ic1414/esp_quad/README.md

# esp_quad

四轴飞行器
quadcopter

## 2022-08-13
esp_quad_v4.1

增加web调参

删除蓝牙调参

## 2022-06-17
esp_quad_v4.0

增加蓝牙调参

支持sbus接收机

支持dshot

删除遥控调参

## 123
支持遥控直接调PID! (正在加蓝牙调参)

不知道要写什么，到时候补充。
