ic1414/esp_quad/pcb/pcb_v2/README.md

## 注意
引脚和 pcb_v1 不兼容，需要去程序改下。

## 物料清单: 
### 无人机:
F450 机架

2212 1000kv 电机(我的电机最大15A)

9047 propeller

Blhelis 30A ESC or 4 in one ESC 

2200mAh 35C lipo (建议选>35C)

飞控

### 飞控
ESP32-WROOM-32U or ESP32-WROOM-32D

AMS1117 3V3  SOT223

MPU6050(GY521)

Buck converter (optional)

NRF24l01 smd or NRF24l01 gt24

0805 resistors 10kX3 & 12kX2 & 3k & 7k5 & 33k

typeA tantalum capacitor 22uf

0805 cerammic capacitor 10ufX2 & 0.1ufX2

jst sh1.0 horizontal smd 4pX2 & 6pX4

pcb 大小:39*39mm

## 图片
图片

图片

图片

图片

## 建议
你可能需要给你的桨叶动平衡。可以用一些胶带。
