ic1414/esp_quad/pcb/pcb_v2/pic.jpg

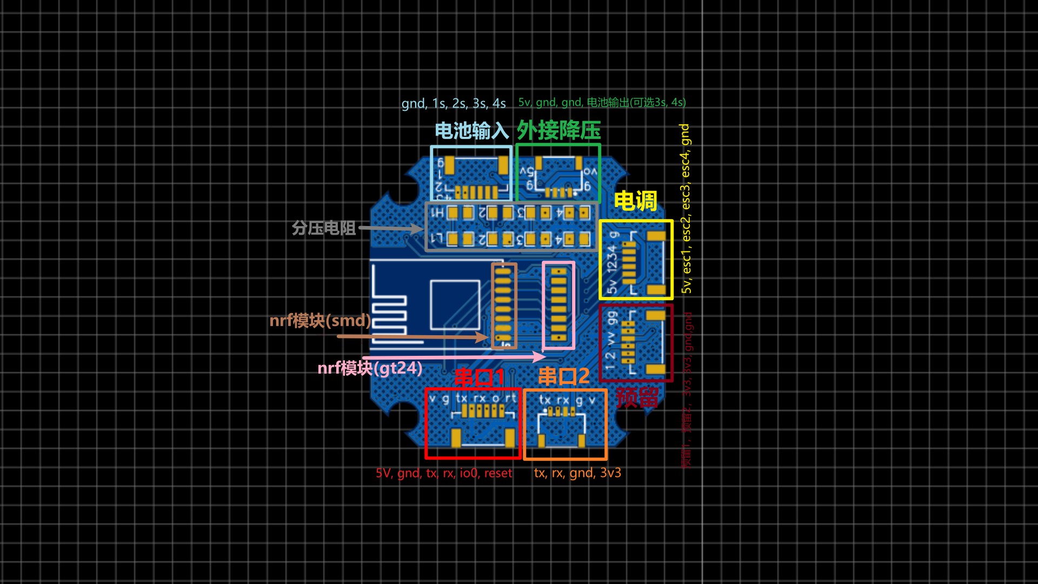
pcb/pcb_v2/pic.jpg
