ic1414/esp_quad/pcb/pcb_v2/schematic2.jpg

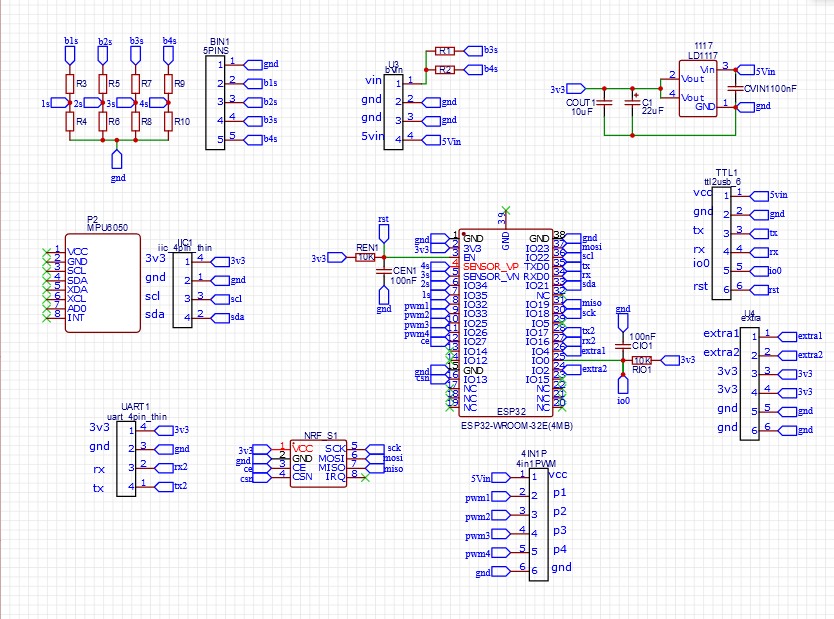
pcb/pcb_v2/schematic2.jpg
