ic1414/esp_quad/document/esp_quad_tutorial_v1/images/board pins.jpeg

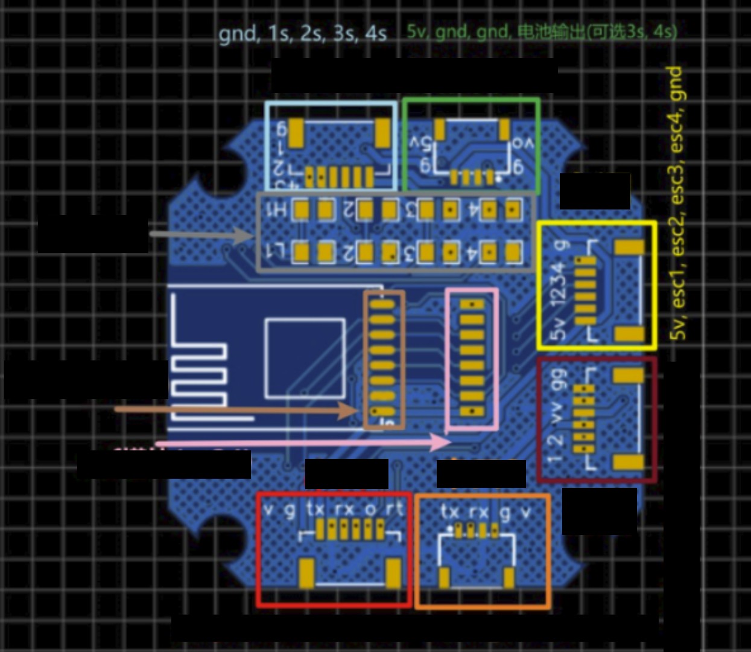
document/esp_quad_tutorial_v1/images/board pins.jpeg
