ic1414/esp_quad/(threads)

Thread 4 (2023-01-13):

Is there a simple\short installation tutorial?

NowLoadY, 2023-01-13:
I'm not very familiar with your project, but I think it interesting. Are there any related video or articles?
And thanks for working on your project, it's nice!

ic1414, 2023-01-14:
Sorry @NowLoadY, there is no short installation tutorial in English yet, but in Chinese. English version will be available soon(within one month).

ic1414, 2023-02-03:
@NowLoadY. you can find tutorial in English here https://github.com/ic1414/esp_quad/tree/main/document/esp_quad_tutorial_v1 .

NowLoadY, 2023-02-03:
> @NowLoadY. you can find tutorial in English here https://github.com/ic1414/esp_quad/tree/main/document/esp_quad_tutorial_v1 .

thanks！！！🙏

Closed 2023-04-06.
