ic1414/esp_quad/src/esp_quad_v4.1/include/inclu.h

#ifndef _inclu_h_
#define _inclu_h_

/*
<SimpleKalmanFilter.h>
-author
Denys Sene
https://github.com/denyssene/SimpleKalmanFilter

*/

#include <Arduino.h>
#include <SimpleKalmanFilter.h>
#include "config.h"
#include "pid.h"
#include "mpu.h"
#include "vtg.h"
#include "motor.h"
#include "wifiServerr.h"
#include "reciever.h"
#include "seriale.h"

#endif
