ic1414/esp_quad/src/esp_quad_v4.1/include/seriale.h

#ifndef _seriale_h_
#define _seriale_h_

#include "config.h"

int serial_zip(){
    
    int delay_time = 10; 
    static char str = '1';
    if (Serial.available() > 0) str = Serial.read();

    switch (str) {
      // print angle
      case 'a':
        Serial.print(imu.getAngle(X));
        Serial.print("   ");
        Serial.print(imu.getAngle(Y));
        Serial.print("   ");
        Serial.println(imu.getAngle(Z));
        break;
      // print gyro
      case 'b':
        Serial.print(imu.getGyro(X));
        Serial.print("   ");
        Serial.print(imu.getGyro(Y));
        Serial.print("   ");
        Serial.println(imu.getGyro(Z));
        break;
      // print acc
      case 'c':
        Serial.print(imu.getAcc(X));
        Serial.print("   ");
        Serial.print(imu.getAcc(Y));
        Serial.print("   ");
        Serial.println(imu.getAcc(Z));
        break;
      // sample count
      case 'd':
        Serial.println(imu.getSampleCount(true));
        delay_time = 1000;
        break;  
      // motor outputs
      case 'e':
        Serial.print("B:");
        Serial.print(motorB.getAStandardisedPwm());
        Serial.print("  A:");
        Serial.print(motorA.getAStandardisedPwm());
        Serial.print("  D:");
        Serial.print(motorD.getAStandardisedPwm());
        Serial.print("  C:");
        Serial.println(motorC.getAStandardisedPwm());
        break;    
      // hi
      case 'f':
        Serial.print("v1s: ");
        Serial.print(voltage.getVoltage(V1));
        Serial.print("  v2s: ");
        Serial.print(voltage.getVoltage(V2));
        Serial.print("  v3s: ");
        Serial.println(voltage.getVoltage(V3));
        break; 

      case 'g':
        Serial.print("x: ");
        Serial.print(imu.getAccAngle(X));
        Serial.print("  y: ");
        Serial.println(imu.getAccAngle(Y));
        break; 

      case 'h':
        // motor outputs
        Serial.print("x:");
        Serial.print(reciever.getJoyStick(X));
        Serial.print("  y:");
        Serial.print(reciever.getJoyStick(Y));
        Serial.print("  z:");
        Serial.print(reciever.getJoyStick(Z));
        Serial.print("  t:");
        Serial.println(reciever.getJoyStick(T));
        break;  

      case 'i':
        // motor outputs
        Serial.print("x:");
        Serial.print(map(reciever.getJoyStick(X), recie_minJoyAnalog, recie_maxJoyAnalog, -recie_maxJoyAngleX, recie_maxJoyAngleX));
        Serial.print("  y:");
        Serial.print(map(reciever.getJoyStick(Y), recie_minJoyAnalog, recie_maxJoyAnalog, -recie_maxJoyAngleY, recie_maxJoyAngleY));
        Serial.print("  z:");
        Serial.println(map(reciever.getJoyStick(Z), recie_minJoyAnalog, recie_maxJoyAnalog, -recie_maxJoyAngleZ, recie_maxJoyAngleZ));
        break;  

    }
    
    return delay_time;
}
#endif
