ic1414/esp_quad/(commit log)

2022-02-16 higher mpu6050 sample rate
    increase mpu6050 sample rate from 1600HZ to 2600HZ
2022-04-10 Add files via upload
    fix mpu6050 code
    [inclu.h, motor.h, mpu.h, pid.h, vtg.h]
2022-04-22 "fixed" z pid problem
    [inclu.h, motor.h, mpu.h, pid.h, vtg.h]
2022-04-22 completely fixed z pid problem
    [esp_quad_v3.7.ino, inclu.h, motor.h, mpu.h, pid.h, vtg.h]
2022-04-28 更新注释
